andkorzh/PPU-LITE/PCB Lattice/V3/readme.md

PPU_LITE PCB on Lattice LCMXO2-1200HC-4TG100C, Version 3

Added optional composite output.
