andkorzh/PPU-LITE/PCB Cyclone I/vga_output.md

A test version of the firmware with support for VGA output. Resolution: 1280×960 at 60 Hz.
Important points for proper implementation:
This works only in NTSC mode (clock frequency 21.47727 MHz).
You also need to install 100-ohm 0805 resistors for the HSYNC and VSYNC pins, as illustrated in the image.

vga_out_cycl1
