andkorzh/PPU-LITE/PCB Lattice/V1/readme.md

PPU_LITE PCB on Lattice LCMXO2-1200HC-4TG100C, Version 1
