andkorzh/PPU-LITE/PCB Lattice/V3/PPU_LITE_LAT_V3.png

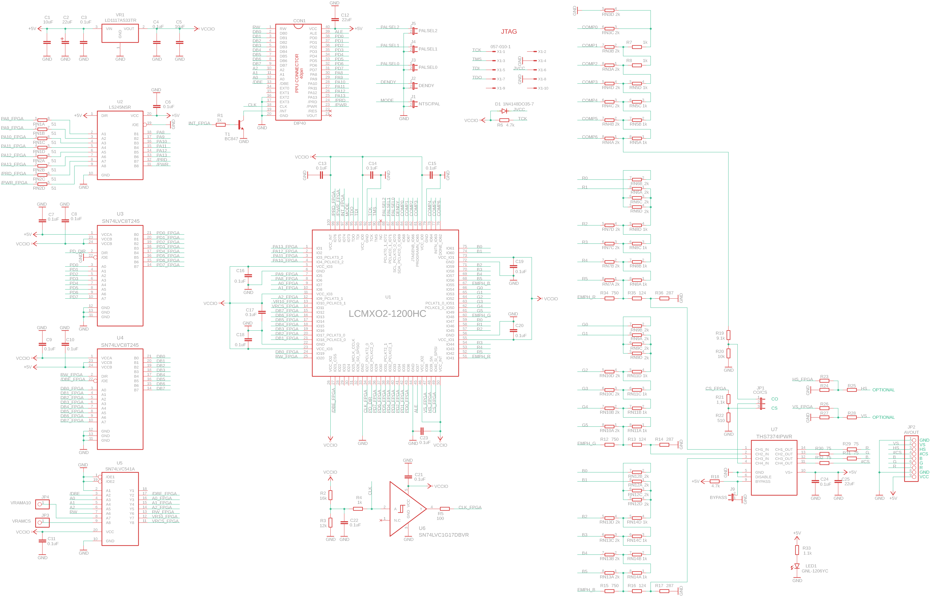
PCB Lattice/V3/PPU_LITE_LAT_V3.png
