andkorzh/PPU-LITE/PCB Lattice/V3/V3 BOT.JPG

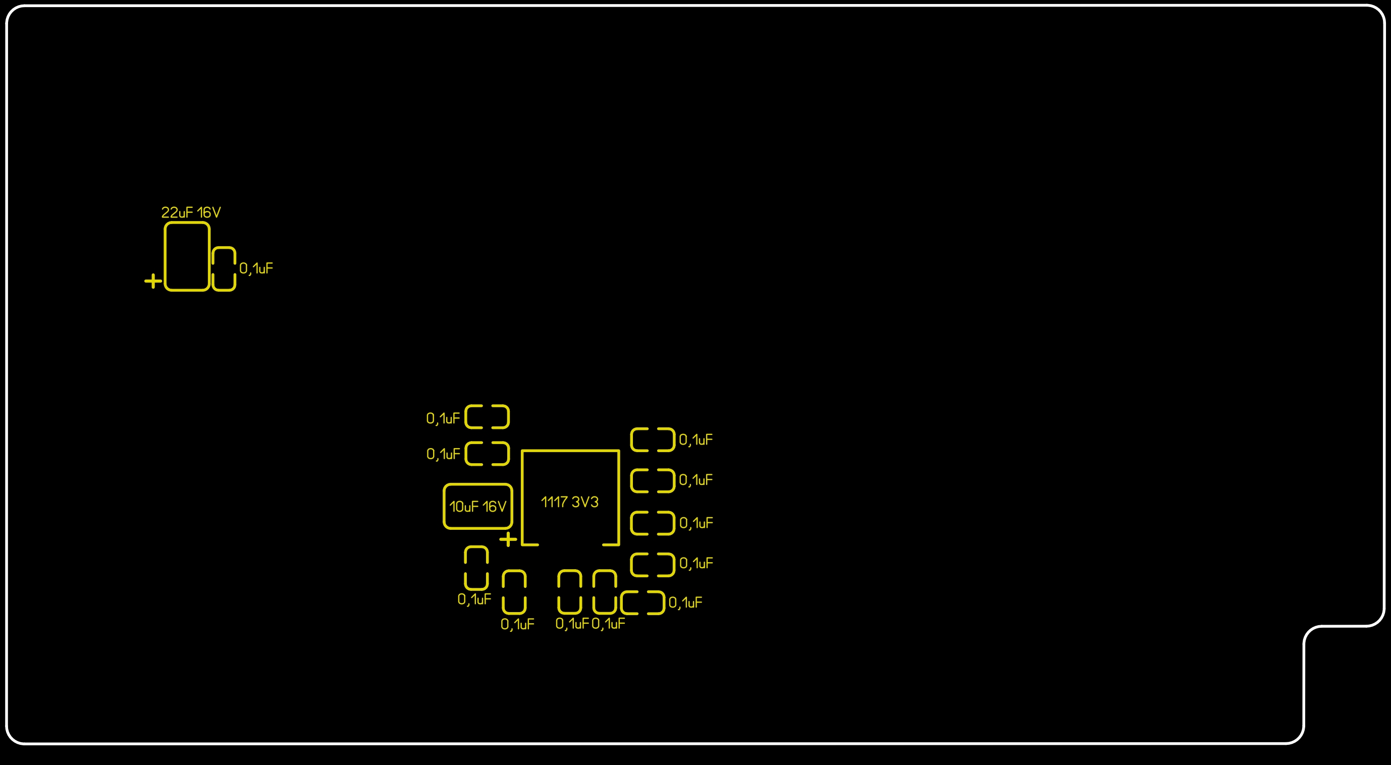
PCB Lattice/V3/V3 BOT.JPG
