andkorzh/PPU-LITE/PCB Lattice/V3/V3 TOP.JPG

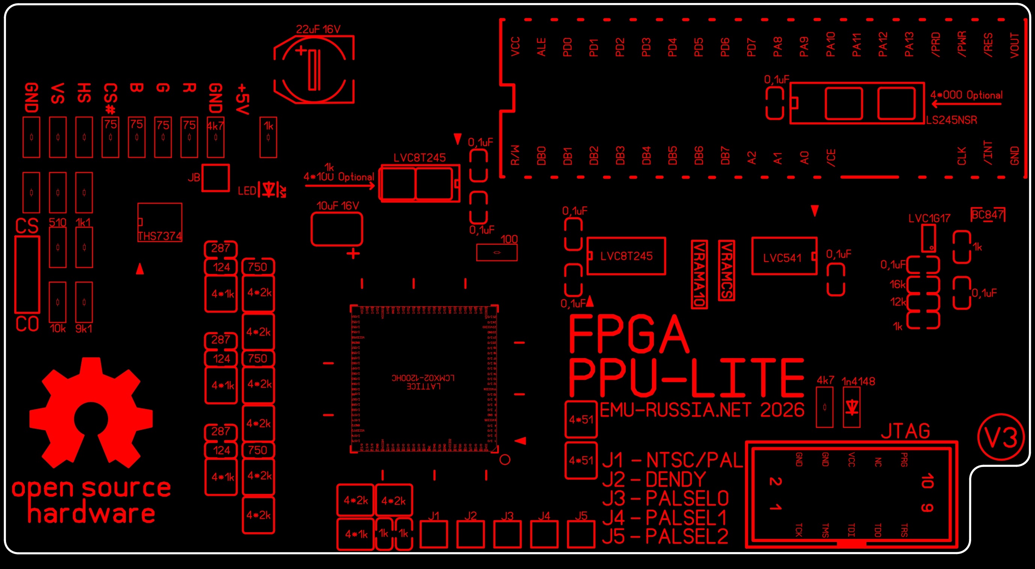
PCB Lattice/V3/V3 TOP.JPG
