andkorzh/PPU-LITE/PPU_MINI/PCB/PPU_MINI.PNG

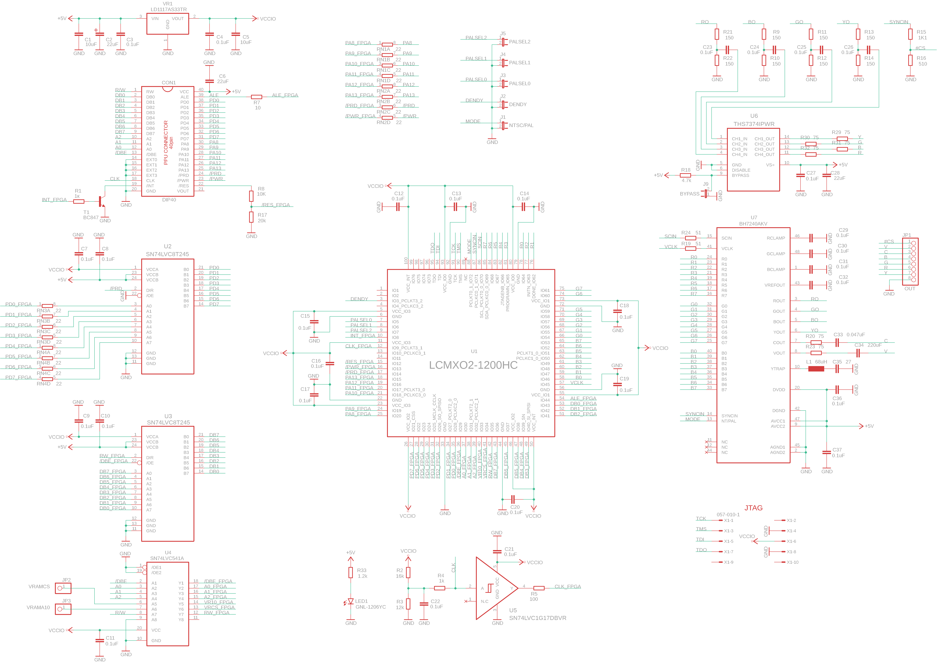
PPU_MINI/PCB/PPU_MINI.PNG
