andkorzh/PPU-LITE/PCB Lattice/V3/BOM PPU_LITE_LATT_V3.xlsx

POS | Q-ty | VALUE | manufacturer | package | PART NUM | SIMILAR
U1,U2 | 2 | SN74LVC8T245PWR | TI | TSSOP-24 | SN74LVC8T245PWR | SN74LVC4245APWR
U3 | 1 | SN74LVC541APW | TI | TSSOP-20 | SN74LVC541APW | 74HC541PW,118,
 | 1 | SN74LS245NSR | TI | SO-20-200 | SN74LS245NSR
U5 | 1 | THS7374IPWR | TI | TSSOP-14 | THS7374IPWR
U6 | 1 | LCMXO2-1200HC-4TG100C | Lattice Semiconductor | TQFP100 | LCMXO2-1200HC-4TG100C | LCMXO2-1200HC TQFP100 any grade
 | 1 | SN74LVC1G17DBVR | TI | SOT-23-5 | SN74LVC1G17DBVR
VR3 | 1 | AMS1117-3.3 | Advanced Monolithic Systems Inc | SOT-223 | AMS1117-3.3 | LD1117-3.3
LED1 | 1 | GNL-1206YC | G-nor Electronics | 1206 | GNL-1206YC | any 1206 SMD LED (YELLOW)
T1 | 1 | BC847-QR | Nexperia B.V. | SOT23 | BC847-QR | 2n3904
 | 1 | 9,1kΩ±5% | YAGEO | 0805 | RC0805JR-079K1L
 | 1 | 16kΩ±5% | YAGEO | 0603 | RC0805JR-0716KL
 | 1 | 12kΩ±5% | YAGEO | 0603 | RC0805JR-0712KL
 | 1 | 10kΩ±5% | YAGEO | 0805 | RC0805JR-0710KL
 | 2 | 4,7kΩ±5% | YAGEO | 0805 | RC0805JR-074K7L
 | 4 | 1kΩ±1% | YAGEO | 0603 | RE0603FRE071KL
R11,R12,R13,R14,R18,R19,R20,R21,R22,R23 | 4 | 75Ω±5% | YAGEO | 0805 | RC0805JR-0775RL
R15 | 2 | 1,1kΩ±5% | YAGEO | 0805 | RC0805JR-071K1L
R16 | 1 | 510Ω±5% | YAGEO | 0805 | RC0805JR-07510RL
R29 | 1 | 100Ω±5% | YAGEO | 0805 | RC0805JR-07100RL
 | 2 | 4х51Ω5% | Bourns | 0603x4 | CAT16-510J4LF
 | 2 | 4х100Ω5% | Bourns | 0603x4 | CAT16-101J4LF | optional
 | 4 | 4х1kΩ1% | Bourns | 0603x4 | CAT16-102J4LF
 | 8 | 4х2kΩ1% | Bourns | 0603x4 | CAT16-202J4LF
 | 3 | 750Ω±1% | YAGEO | 0603 | RC0603FR-07750RL
 | 3 | 124Ω±1% | Vishay/Dale | 0603 | CRCW0603124RFKEA
 | 3 | 287Ω±1% | KOA Speer Electronics | 0603 | RK73H1JTTD2870F
C1,C2,C3,C4,C6,C7,C9,C10,C12,C13,C16,C18,C19,C21,C22,C23,C24,C25,C26,C27,C28,C29,C30,C31,C40,C43 | 20 | 0.1uF X7R 16V 10% | Murata | 0603 | GRM188R71C104KA01D
 | 2 | tantal 22uF 16V 20% | AVX | 1210 | TAJB226M016RNJ
 | 1 | tantal 10uF 16V 20% | AVX | 1210 | TAJB106M016RNJ
 | 1 | 22uF 25V 20% | JB Capacitors |  | JCK1E220M050054
jtag con | 1 | BH-10 (DS1013-10S) (IDC-10MS) | CONNFLY | 2*5*2.54 | DS1013-10SSiB1-B-0
 | 1 | 1N4148W | EVVOSEMI | SOD - 123 | 1N4148W
