andkorzh/PPU-LITE/(commit log)

2025-12-31 PCB v2.1
2026-02-28 Create BOM PPU_LITE_LATT_V1.xlsx
    [BOM PPU_LITE_LATT_V1.xlsx]
2026-03-15 GERBER Lattice V3 PCB
2026-03-18 BOM v3
    [BOM PPU_LITE_LATT_V3.xlsx]
