andkorzh/PPU-LITE/(notices)

Notices in the files:
Quartus/RP2C02_LITE_RUS.v:
modify it under the terms of the GNU General Public License
